botsqerebot/AudioDeck/Case/case/frontv3.stl

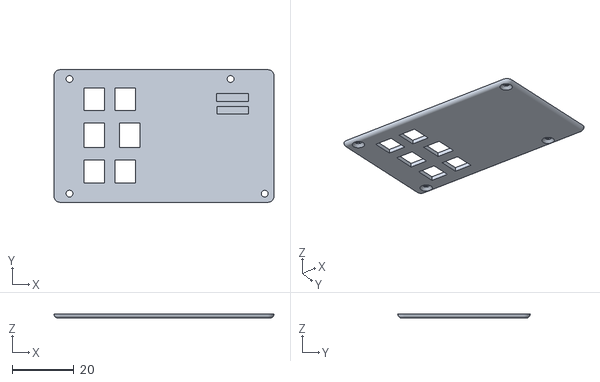
[picture p1: CAD file, 2026-10-12]
Case/case/frontv3.stl
71.0 x 42.8 x 1.40
