botsqerebot/AudioDeck/Case/case/battery_cover.stl

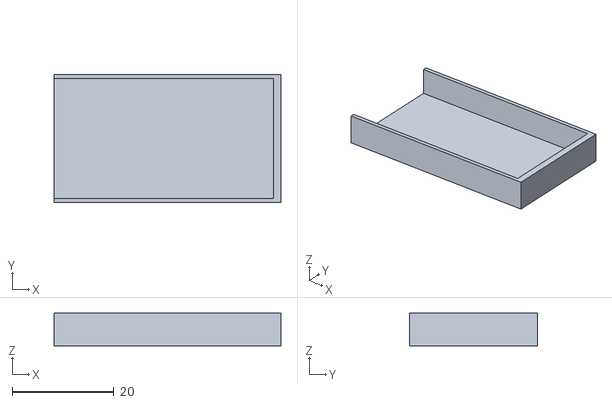
[picture p2: CAD file, 2026-10-12]
Case/case/battery_cover.stl
44.7 x 25.3 x 6.43
