botsqerebot/AudioDeck/Case/case/frontv7.stl

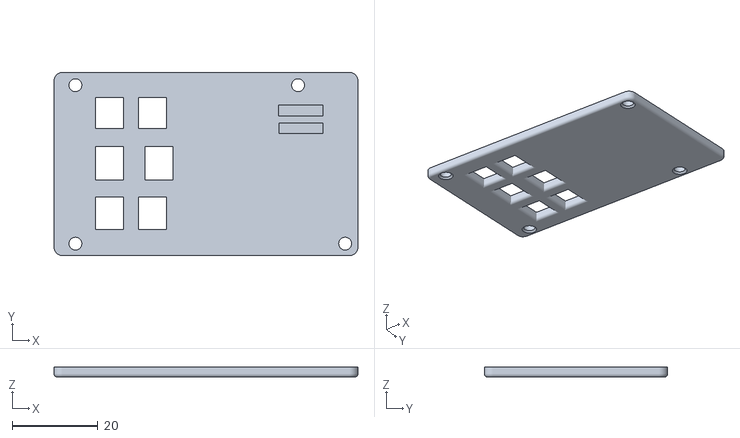
[picture p3: CAD file, 2026-10-12]
Case/case/frontv7.stl
71.0 x 42.8 x 2.40
