botsqerebot/AudioDeck/Case/case/back.step

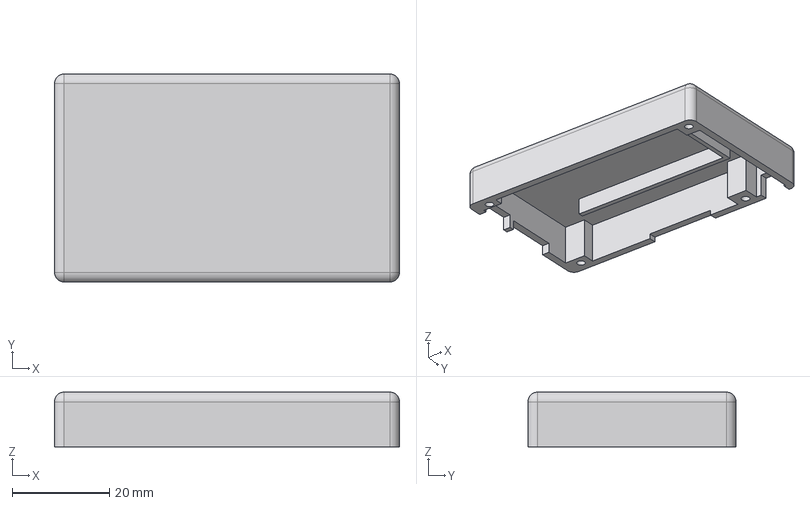
[picture p4: CAD file, 2026-10-12]
Case/case/back.step
71.0 x 42.8 x 11.3 mm
