botsqerebot/AudioDeck/Case/case/frontv6.stl

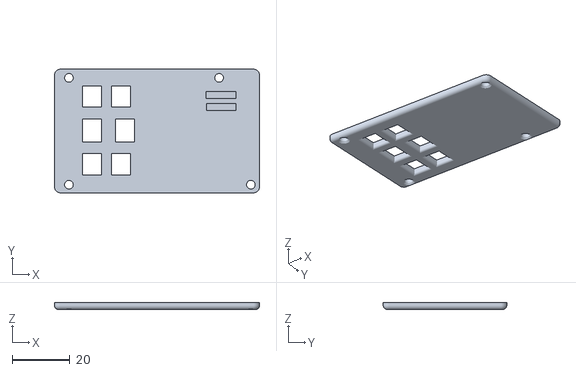
[picture p5: CAD file, 2026-10-12]
Case/case/frontv6.stl
71.0 x 42.8 x 2.40
