botsqerebot/AudioDeck/Case/case/front.stl

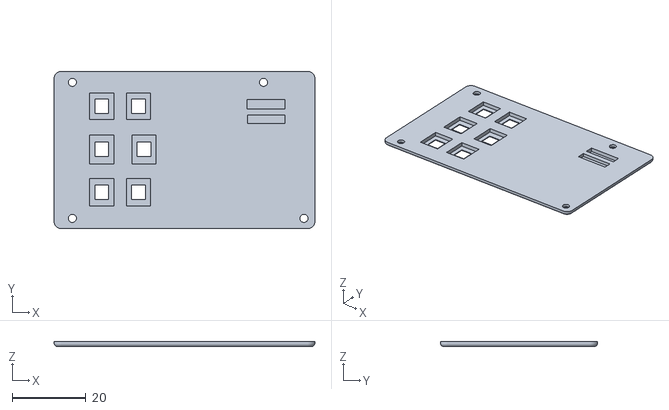
[picture p6: CAD file, 2026-10-12]
Case/case/front.stl
71.0 x 42.8 x 1.40
