botsqerebot/AudioDeck/Case/case/frontv4.stl

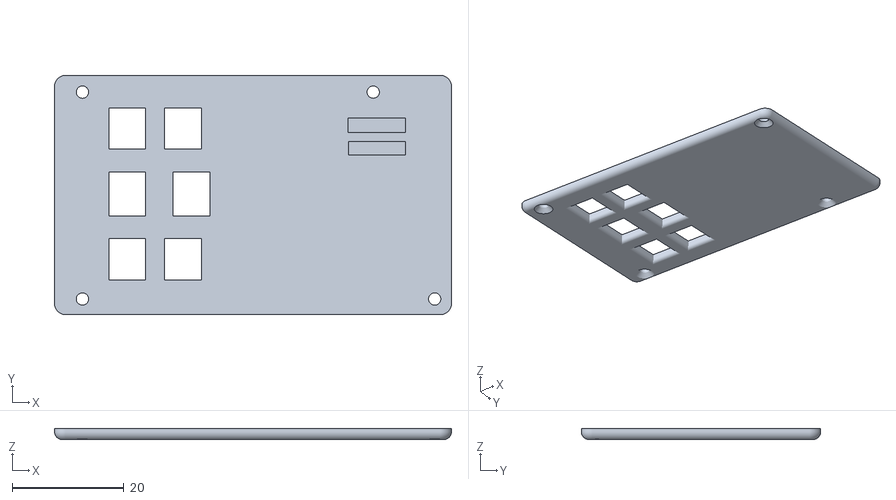
[picture p7: CAD file, 2026-10-12]
Case/case/frontv4.stl
71.0 x 42.8 x 2.00
