botsqerebot/AudioDeck/Case/case/frontv5.stl

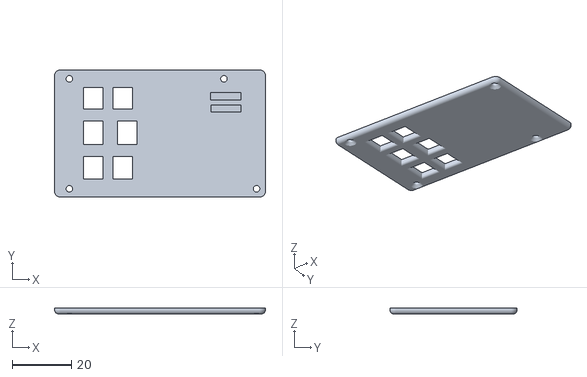
[picture p8: CAD file, 2026-10-12]
Case/case/frontv5.stl
71.0 x 42.8 x 2.00
