botsqerebot/AudioDeck/Case/case/frontv2.stl

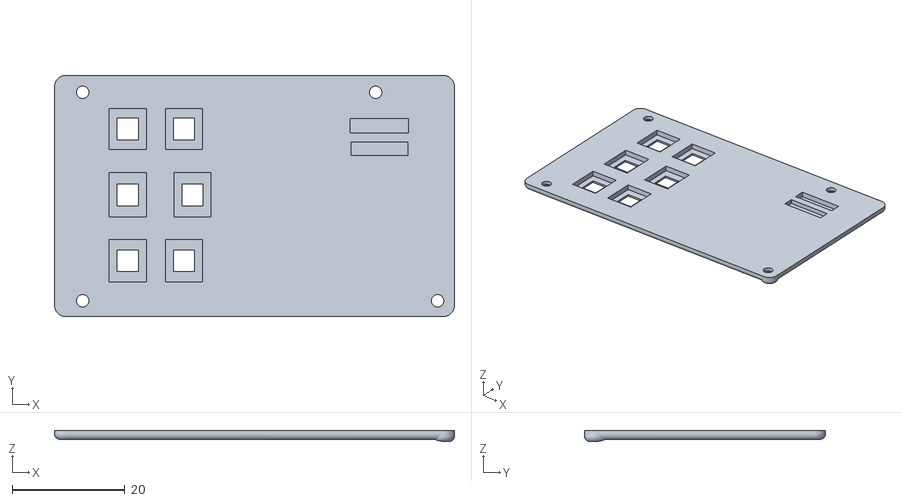
[picture p9: CAD file, 2026-10-12]
Case/case/frontv2.stl
71.0 x 42.8 x 2.00
