botsqerebot/AudioDeck/(list of files, cad)

Other CAD files:
Case/case/shapr3d_export_2026-08-29_23h02m.stl
Case/case/frontv8.stl
