botsqerebot/AudioDeck/PCB/cadProd_compact.kicad_pcb

## KiCad design PCB/cadProd_compact.kicad_pcb (2026-11-02)

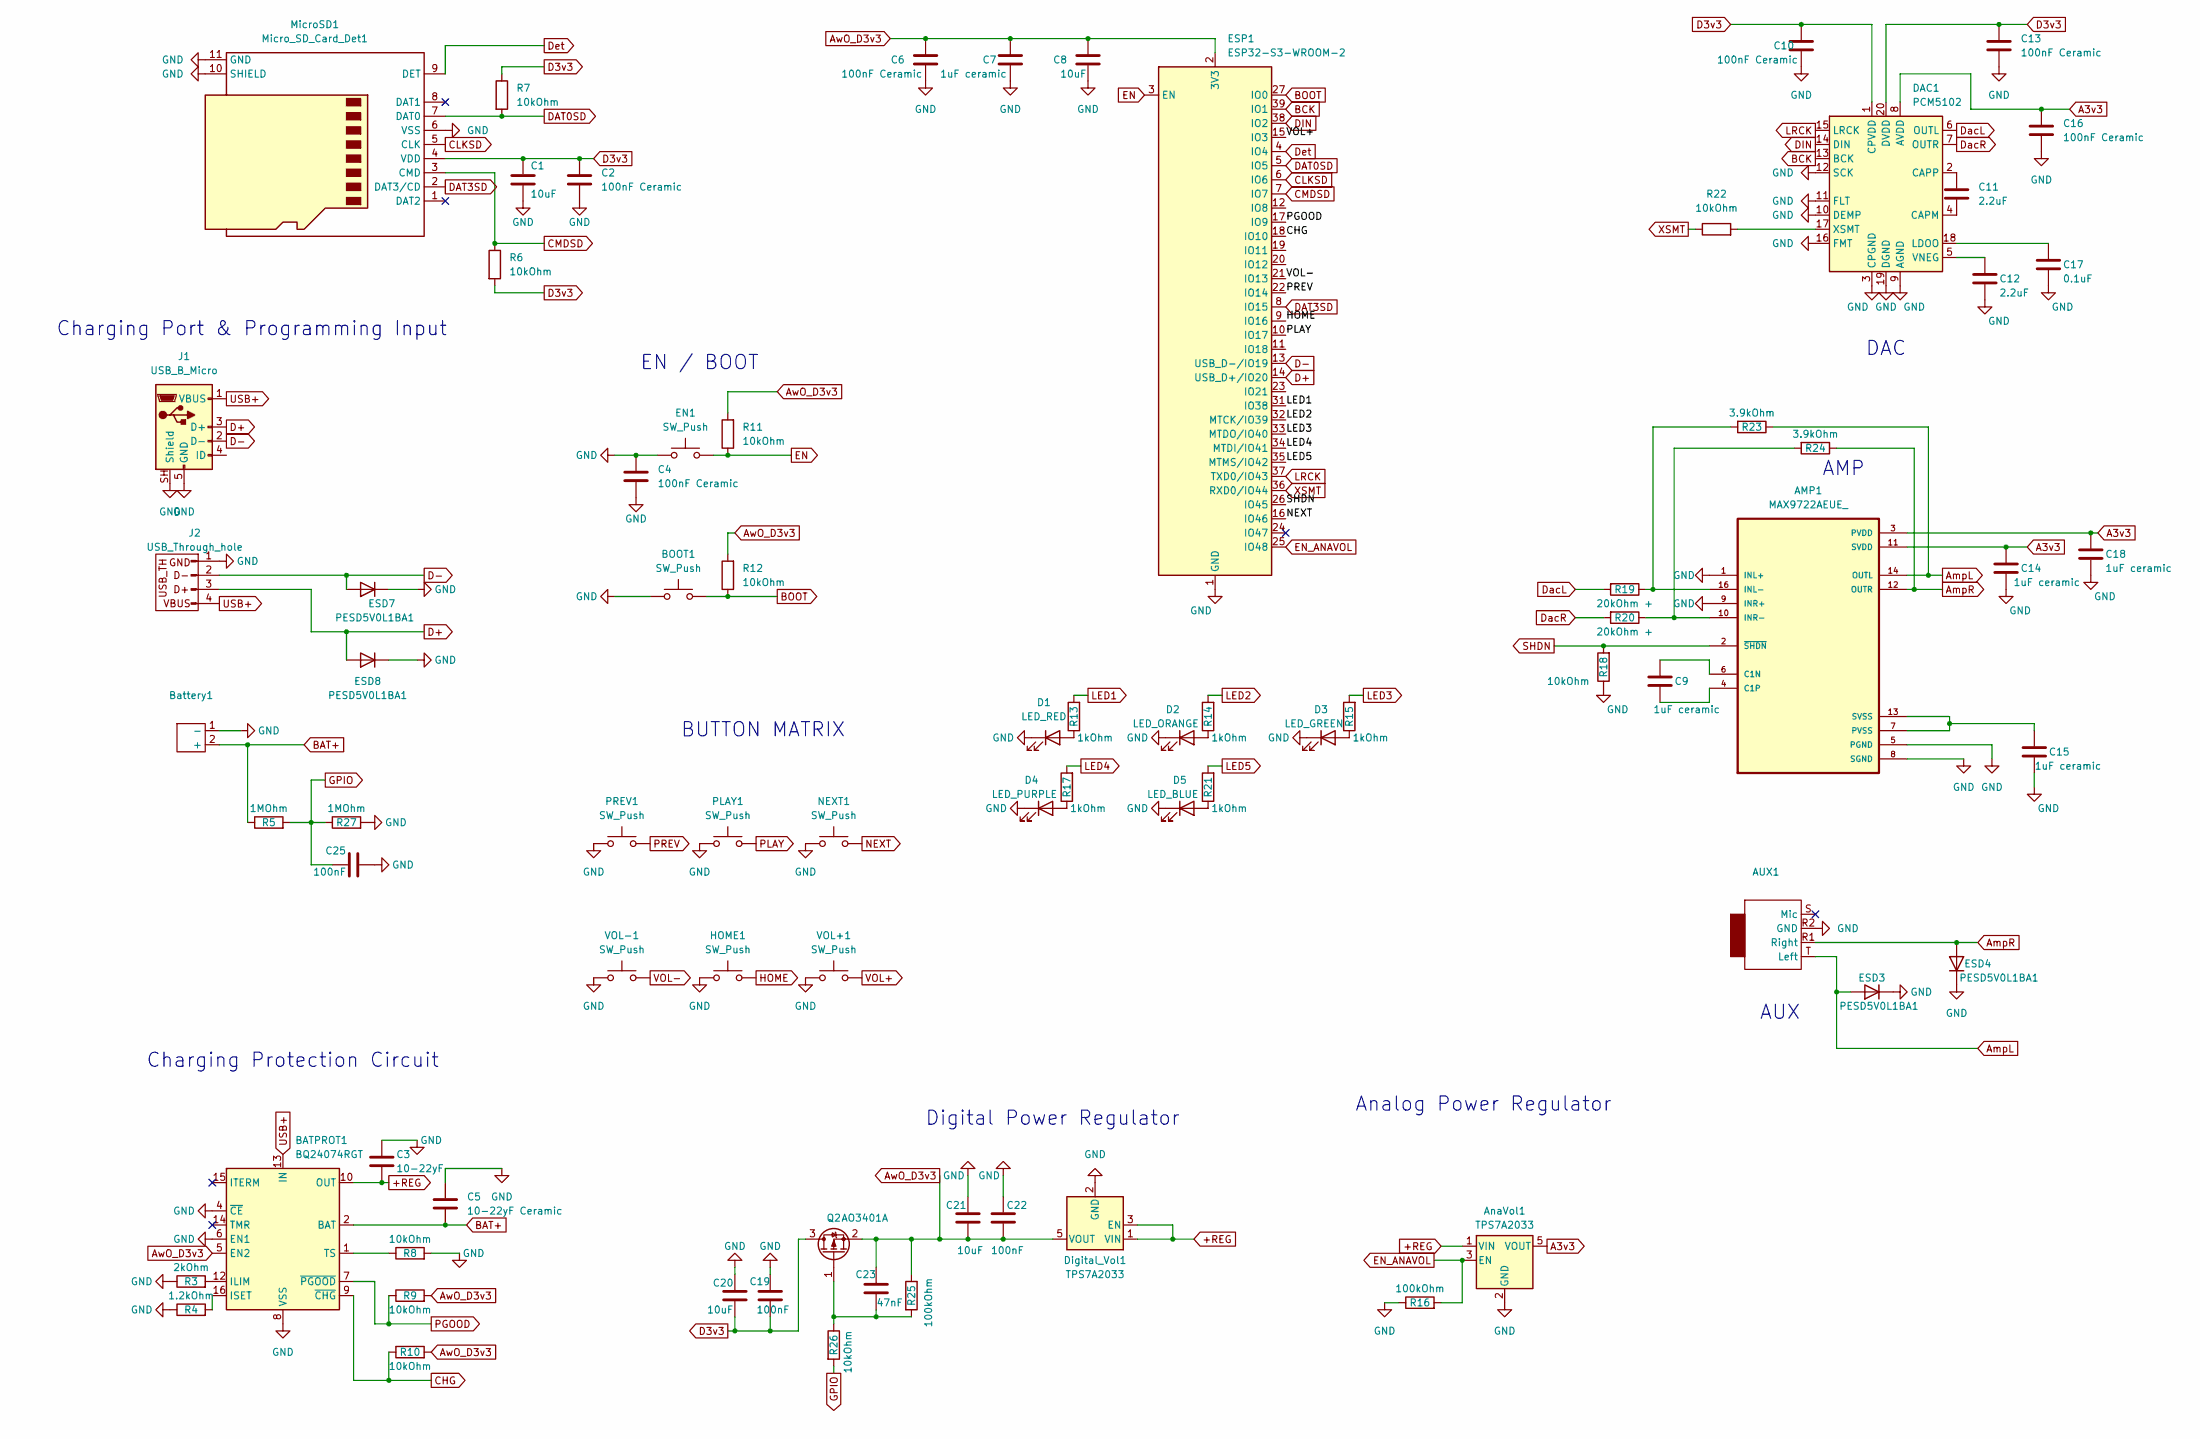
[picture p10: schematic cadProd_compact.kicad_sch]

Parts:
AMP1: MAX9722AEUE_; SOP65P640X110-16N
AUX1: Jack_3.5mm_PJ320D_Horizontal
AnaVol1: TPS7A2033; SOT-23-5
BATPROT1: BQ24074RGT; VQFN-16-1EP_3x3mm_P0.5mm_EP1.8x1.8mm
BOOT1: SW_Push; SW_Push_SPST_NO_Alps_SKRK
Battery1: JST_PH_B2B-PH-K_1x02_P2.00mm_Vertical
C1, C8, C20, C21: 10uF; C_0805_2012Metric_Pad1.18x1.45mm_HandSolder
C2, C4, C6, C10, C13, C16: 100nF Ceramic; C_0805_2012Metric_Pad1.18x1.45mm_HandSolder
C3: 10-22yF; C_0805_2012Metric_Pad1.18x1.45mm_HandSolder
C5: 10-22yF Ceramic; C_0805_2012Metric_Pad1.18x1.45mm_HandSolder
C7, C9, C14, C15, C18: 1uF ceramic; C_0805_2012Metric_Pad1.18x1.45mm_HandSolder
C11, C12: 2.2uF; C_0805_2012Metric_Pad1.18x1.45mm_HandSolder
C17: 0.1uF; C_0805_2012Metric_Pad1.18x1.45mm_HandSolder
C19, C22, C25: 100nF; C_0805_2012Metric_Pad1.18x1.45mm_HandSolder
C23: 47nF; C_0805_2012Metric_Pad1.18x1.45mm_HandSolder
D1: LED_RED; LED_0805_2012Metric_Pad1.15x1.40mm_HandSolder
D2: LED_ORANGE; LED_0805_2012Metric_Pad1.15x1.40mm_HandSolder
D3: LED_GREEN; LED_0805_2012Metric_Pad1.15x1.40mm_HandSolder
D4: LED_PURPLE; LED_0805_2012Metric_Pad1.15x1.40mm_HandSolder
D5: LED_BLUE; LED_0805_2012Metric_Pad1.15x1.40mm_HandSolder
DAC1: PCM5102; TSSOP-20_4.4x6.5mm_P0.65mm
Digital_Vol1: TPS7A2033; SOT-23-5
EN1: SW_Push; SW_Push_SPST_NO_Alps_SKRK
ESD3, ESD4, ESD7, ESD8: PESD5V0L1BA1; D_SOD-323
ESP1: ESP32-S3-WROOM-2
HOME1: SW_Push; SW_SPST_SKQG_WithStem
J1: USB_B_Micro; USB_Micro-B_Wuerth_629105150521
J2: USB_Through_hole; PinHeader_1x04_P2.54mm_Vertical_USB
MicroSD1: Micro_SD_Card_Det1; microSD_HC_Hirose_DM3AT-SF-PEJM5
NEXT1: SW_Push; SW_SPST_SKQG_WithStem
PLAY1: SW_Push; SW_SPST_SKQG_WithStem
PREV1: SW_Push; SW_SPST_SKQG_WithStem
Q2: AO3401A; SOT-23
R3: 2kOhm; R_0805_2012Metric_Pad1.20x1.40mm_HandSolder
R4: 1.2kOhm; R_0805_2012Metric_Pad1.20x1.40mm_HandSolder
R5, R27: 1MOhm; R_0805_2012Metric_Pad1.20x1.40mm_HandSolder
R6, R7, R8, R9, R10, R11, R12, R18, R22, R26: 10kOhm; R_0805_2012Metric_Pad1.20x1.40mm_HandSolder
R13, R14, R15, R17, R21: 1kOhm; R_0805_2012Metric_Pad1.20x1.40mm_HandSolder
R16, R25: 100kOhm; R_0805_2012Metric_Pad1.20x1.40mm_HandSolder
R19, R20: 20kOhm +; R_0805_2012Metric_Pad1.20x1.40mm_HandSolder
R23, R24: 3.9kOhm; R_0805_2012Metric_Pad1.20x1.40mm_HandSolder
VOL+1: SW_Push; SW_SPST_SKQG_WithStem
VOL-1: SW_Push; SW_SPST_SKQG_WithStem

Connections:
+REG: AnaVol1.1 (VIN), BATPROT1.10 (OUT), BATPROT1.11 (OUT), C3.2, Digital_Vol1.1 (VIN), Digital_Vol1.3 (EN)
A3v3: AMP1.3 (PVDD), AMP1.11 (SVDD), AMP1.15 (SVDD), AnaVol1.5 (VOUT), C14.1, C16.1, C18.1, DAC1.8 (AVDD); also elsewhere on the board
AmpL: AMP1.14 (OUTL), AUX1.T (Left), ESD3.2 (A), R23.1
AmpR: AMP1.12 (OUTR), AUX1.R1 (Right), ESD4.2 (A), R24.1
AwO_D3v3: BATPROT1.5 (EN2), C6.1, C7.1, C8.1, C21.2, C22.2, C23.1, Digital_Vol1.5 (VOUT), ESP1.2 (3V3), Q2.2 (S), R9.2, R10.2, R11.2, R12.2, R25.1
BAT+: BATPROT1.2 (BAT), BATPROT1.3 (BAT), Battery1.2 (+), C5.2, R5.1
BCK: DAC1.13 (BCK), ESP1.39 (IO1)
BOOT: BOOT1.2, ESP1.27 (IO0), R12.1
CHG: BATPROT1.9 (~CHG), ESP1.18 (IO10), R10.1
CLKSD: ESP1.6 (IO6), MicroSD1.5 (CLK)
CMDSD: ESP1.7 (IO7), MicroSD1.3 (CMD), R6.1
D3v3: C1.1, C2.1, C10.1, C13.1, C19.2, C20.2, DAC1.1 (CPVDD), DAC1.20 (DVDD), MicroSD1.4 (VDD), Q2.3 (D), R6.2, R7.1
D+: ESD8.2 (A), ESP1.14 (USB_D+/IO20), J1.3 (D+), J2.3
D-: ESD7.2 (A), ESP1.13 (USB_D-/IO19), J1.2 (D-), J2.2 (D-)
DAT0SD: ESP1.5 (IO5), MicroSD1.7 (DAT0), R7.2
DAT3SD: ESP1.8 (IO15), MicroSD1.2 (DAT3/CD)
DIN: DAC1.14 (DIN), ESP1.38 (IO2)
DacL: DAC1.6 (OUTL), R19.2
DacR: DAC1.7 (OUTR), R20.2
Det: ESP1.4 (IO4), MicroSD1.9 (DET)
EN: EN1.2, ESP1.3 (EN), R11.1
EN_ANAVOL: AnaVol1.3 (EN), ESP1.25 (IO48), R16.2
GND: AMP1.1 (INL+), AMP1.5 (PGND), AMP1.8 (SGND), AMP1.9 (INR+), AUX1.R2 (GND), AnaVol1.2 (GND), BATPROT1.4 (~CE), BATPROT1.6 (EN1), BATPROT1.8 (VSS), BATPROT1.17 (VSS), BOOT1.1, Battery1.1 (-), C1.2, C2.2, C3.1, C4.1, C4.2, C5.1, C6.2, C7.2, C8.2, C10.2, C12.2, C13.2, C14.2, C15.2, C16.2, C17.2, C18.2, C19.1, C20.1, C21.1, C22.1, C25.2, D1.1 (K), D2.1 (K), D3.1 (K), D4.1 (K), D5.1 (K), DAC1.3 (CPGND), DAC1.9 (AGND), DAC1.10 (DEMP), DAC1.11 (FLT), DAC1.12 (SCK), DAC1.16 (FMT), DAC1.19 (DGND), Digital_Vol1.2 (GND), EN1.1, ESD3.1 (K), ESD4.1 (K), ESD7.1 (K), ESD8.1 (K), ESP1.1 (GND), ESP1.40 (GND), ESP1.41 (GND), HOME1.1, J1.5 (GND), J1.SH (Shield), J2.1, MicroSD1.6 (VSS), MicroSD1.10 (SHIELD), MicroSD1.11 (GND), NEXT1.1, PLAY1.1, PREV1.1, R3.1, R4.1, R8.2, R16.1, R18.1, R27.2, VOL+1.1, VOL-1.1
GPIO: C25.1, R5.2, R26.2, R27.1
HOME: ESP1.9 (IO16), HOME1.2
LED1: ESP1.31 (IO38), R13.2
LED2: ESP1.32 (MTCK/IO39), R14.2
LED3: ESP1.33 (MTDO/IO40), R15.2
LED4: ESP1.34 (MTDI/IO41), R17.2
LED5: ESP1.35 (MTMS/IO42), R21.2
LRCK: DAC1.15 (LRCK), ESP1.37 (TXD0/IO43)
NEXT: ESP1.16 (IO46), NEXT1.2
unnamed: AMP1.6 (C1N), C9.1
unnamed: AMP1.4 (C1P), C9.2
unnamed: AMP1.16 (INL-), R19.1, R23.2
unnamed: AMP1.10 (INR-), R20.1, R24.2
unnamed: AMP1.7 (PVSS), AMP1.13 (SVSS), C15.1
unnamed: BATPROT1.12 (ILIM), R3.2
unnamed: BATPROT1.16 (ISET), R4.2
unnamed: BATPROT1.1 (TS), R8.1
unnamed: D1.2 (A), R13.1
unnamed: D2.2 (A), R14.1
unnamed: D3.2 (A), R15.1
unnamed: D4.2 (A), R17.1
unnamed: D5.2 (A), R21.1
unnamed: C11.2, DAC1.4 (CAPM)
unnamed: C11.1, DAC1.2 (CAPP)
unnamed: C17.1, DAC1.18 (LDOO)
unnamed: C12.1, DAC1.5 (VNEG)
unnamed: DAC1.17 (XSMT), R22.2
unnamed: C23.2, Q2.1 (G), R25.2, R26.1
PGOOD: BATPROT1.7 (~PGOOD), ESP1.17 (IO9), R9.1
PLAY: ESP1.10 (IO17), PLAY1.2
PREV: ESP1.22 (IO14), PREV1.2
SHDN: AMP1.2 (~SHDN), ESP1.26 (IO45), R18.2
USB+: BATPROT1.13 (IN), J1.1 (VBUS), J2.4
VOL+: ESP1.15 (IO3), VOL+1.2
VOL-: ESP1.21 (IO13), VOL-1.2
XSMT: ESP1.36 (RXD0/IO44), R22.1

Notes on the sheet:
Charging Port & Programming Input
BUTTON MATRIX
EN / BOOT
Charging Protection Circuit
AMP
DAC
AUX
Analog Power Regulator
Digital Power Regulator

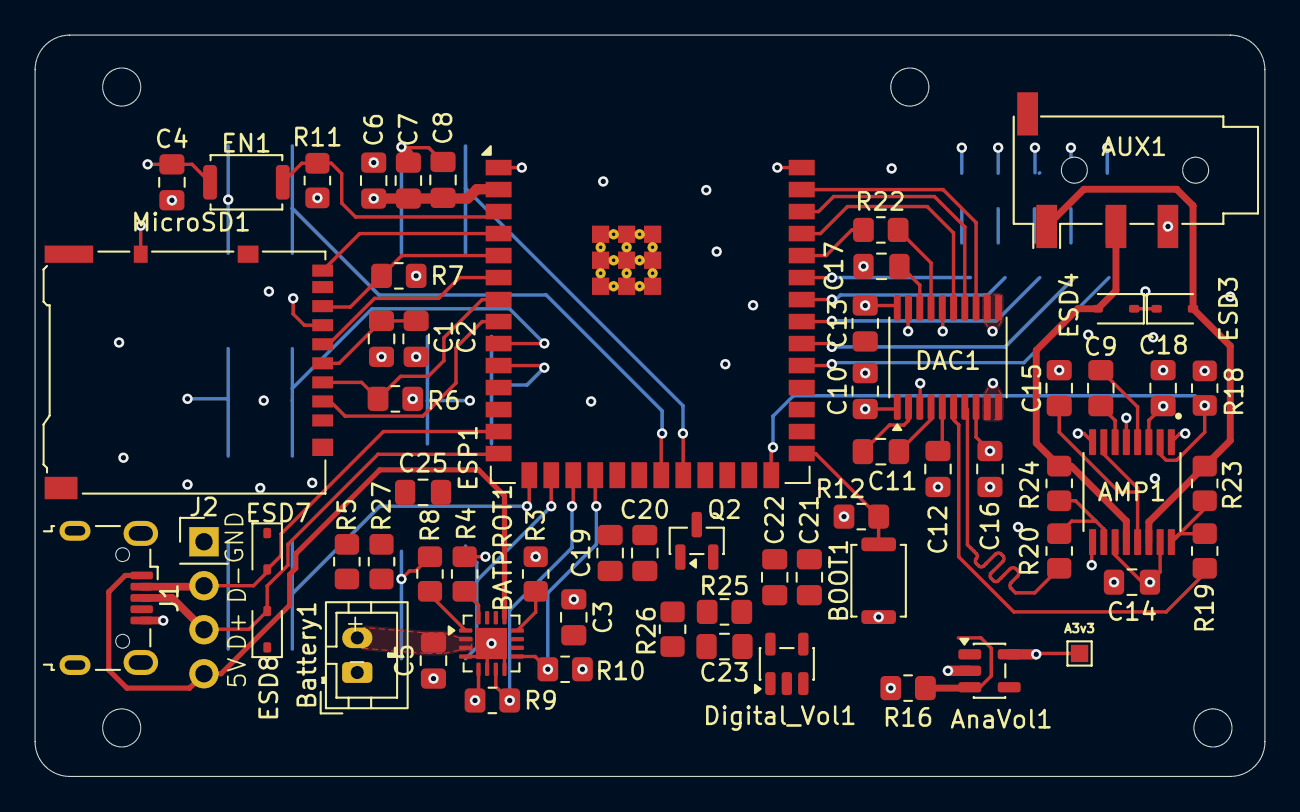
[picture p11: board cadProd_compact.kicad_pcb from above]

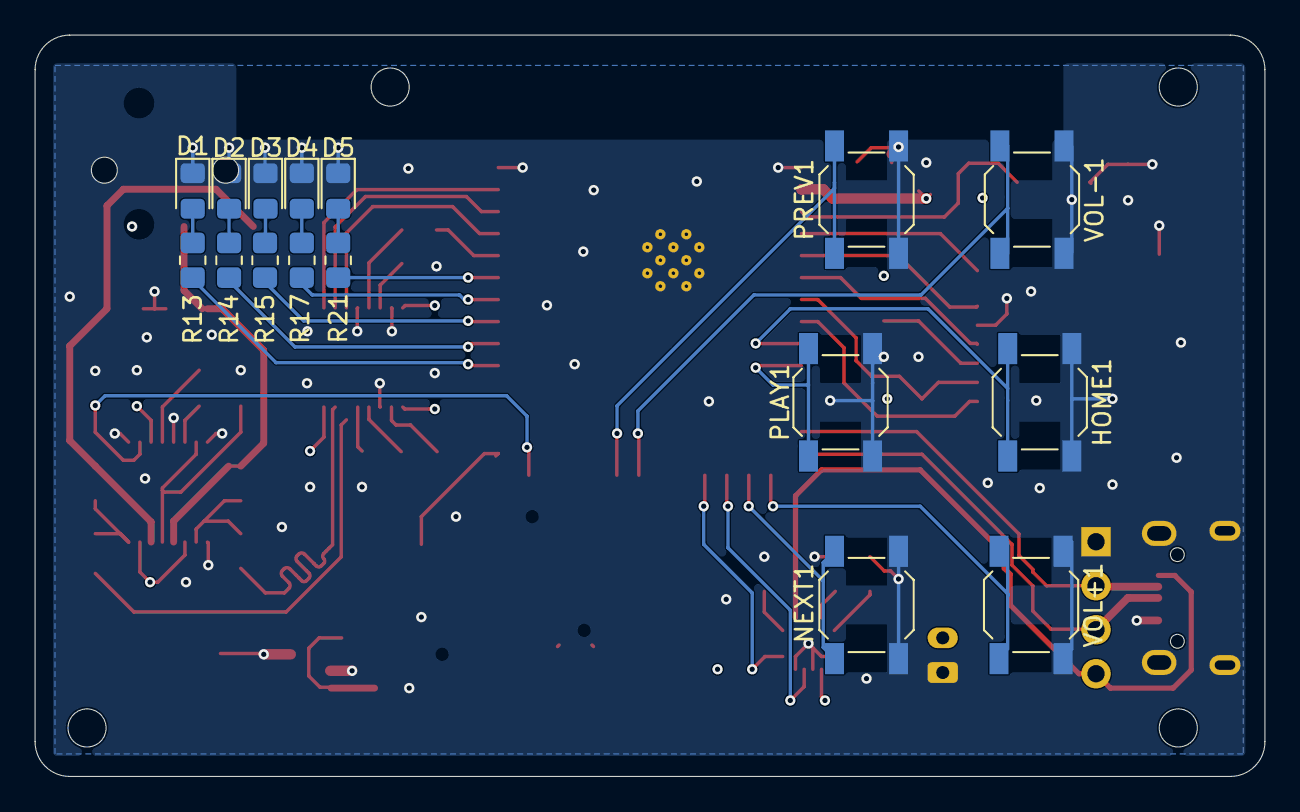
[picture p12: board cadProd_compact.kicad_pcb from below]

Board: 4 copper layers, 71.0 x 42.8 mm, 79 parts (16 on the bottom side), 59 nets.

Other parts of the board:
A3v3: TestPoint_Pad_1.0x1.0mm

Their connections:
A3v3: A3v3.1; also elsewhere on the board
