botsqerebot/AudioDeck/(commit log)

2026-10-12 Improve audio output and voice studio assets
    Switch the ESP32 player to 32-bit I2S output with linear anti-mute handling, rate diagnostics, and configurable hiss testing. Update voice menu discovery and documentation, and bundle additional Piper voice models.
2026-10-17 sum sum
    [cadProd_compact.kicad_pcb, cadProd_compact.kicad_sch]
2026-10-17 updated pcb
    [cadProd_compact.kicad_sch]
